Valentin-Auger-Laboratoire/athletix-data/architecture/INTEGRATION.md

# Intégration réseau : du muscle à la base de données

> Auteur : Othmen Al Bydeoi — architecture système. Version 1.0 (novembre 2026).

## 1. Le chemin des données

```
 Muscle ──► MyoWare 2.0 ──► ESP32-S3 ══ Bluetooth LE ══► Application ══ HTTPS ══► API PHP ──► MySQL
          (enveloppe        (RMS, % MVC,  (GATT, 50 Hz)   (affichage,    (POST +    (backend/)  (résultats,
           analogique)       alerte)                       résumé)        jeton)                  calibrations)
```

Il y a **deux liaisons**, chacune avec son rôle :

| Liaison | Technologie | Ce qui passe | Fréquence |
|---|---|---|---|
| Brassard → application | Bluetooth Low Energy, GATT (voir `GATT.md`) | chaque mesure, 8 octets | ~50 par seconde |
| Application → serveur | HTTPS, formulaire POST + jeton de session | un **résumé** par séance, une ligne par calibration | quelques fois par jour |

**Le brassard ne parle jamais directement au serveur.** Il n'a pas d'accès Internet, ni de compte. C'est l'application, déjà connectée avec le jeton de l'utilisateur, qui relaie. Cela corrige une incohérence de la version précédente : `update_hardware.php` demandait au brassard le jeton de session d'un utilisateur, ce qu'un objet connecté ne peut pas avoir.

## 2. Routes de l'API ajoutées

Toutes en `POST`, avec le champ `token` (jeton de session), comme le reste de l'API.

### `save_seance.php`

Enregistre une séance terminée et son résumé EMG, dans une transaction (soit tout est enregistré, soit rien).

| Champ | Obligatoire | Contrôle |
|---|---|---|
| `discipline` | oui | 1 à 50 caractères |
| `duree_s` | oui | 1 à 21 600 (6 h) |
| `nb_echantillons` | oui | ≥ 0 |
| `intensite_moyenne_pct`, `intensite_max_pct` | oui | 0 à 255, moyenne ≤ max |
| `temps_effort_intense_s` | oui | 0 à `duree_s` |
| `nb_alertes` | oui | ≥ 0 |
| `simule` | non | `1` si les données viennent du brassard simulé |
| `numero_serie`, `firmware` | non | si présents : le brassard est créé ou mis à jour et lié à l'utilisateur |
| `ref_mvc_mv` | non | 100 à 3300 |
| `temps_zone_repos_s`, `temps_zone_moderee_s`, `temps_zone_soutenue_s` | non | 0 à 21 600 (zones < 20 %, 20–50 %, 50–75 % ; la zone ≥ 75 % est `temps_effort_intense_s`) |
| `nb_contractions` | non | 0 à 65 535 (hystérésis 30 / 20 %) |
| `indice_fatigue_pct` | non | −100 à 1000 (expérimental, voir `lib/services/analyse/analyse_seance.dart`) |
| `courbe` | non | liste JSON d'au plus 2 000 entiers de 0 à 255, une valeur toutes les 5 s |
| `distance_m`, `denivele_m`, `vitesse_moy_kmh`, `nb_pas` | non | GPS et accéléromètre du téléphone ; la vitesse accepte la virgule |
| `fc_moy`, `fc_max` | non | 30 à 230 / 240, moyenne ≤ max (ceinture cardio) |
| `temperature_c`, `humidite_pct`, `meteo_code` | non | météo Open-Meteo au départ (code WMO 0 à 99) |
| `ressenti_fatigue`, `douleur` | non | 0 à 10 |
| `sommeil`, `commentaire` | non | 20 et 500 caractères au plus |
| `mode_adapte` | non | `1` si la séance a été faite en mode adapté |

Les champs facultatifs demandent la migration `003_contexte_telephone.sql`.

Réponse : `{"status":"success","session_id":12}` ou `{"status":"error","message":"…"}` avec un message précis.

### `save_calibration.php`

| Champ | Contrôle |
|---|---|
| `numero_serie` | 4 à 32 caractères (lettres, chiffres, tirets) |
| `firmware` | facultatif |
| `ref_mvc_mv` | 100 à 3300 |

## 3. Le choix à trancher : Bluetooth dans le navigateur ou application Android ?

L'application est aujourd'hui en **Flutter Web**. Le Bluetooth dans un navigateur passe par l'API **Web Bluetooth**, qui a des limites fortes :

| | Web Bluetooth (Chrome) | Application Android (Flutter) |
|---|---|---|
| Navigateurs / appareils | Chrome et Edge sur ordinateur et Android. **Pas** sur iPhone, **pas** sur Firefox | tous les Android récents |
| Conditions | site en HTTPS, l'utilisateur doit cliquer pour choisir l'appareil | permissions Bluetooth à demander |
| Identifiant de l'appareil | opaque (pas d'adresse MAC) → on utilise le numéro de série GATT | adresse MAC disponible |
| Démo en ligne (GitHub Pages) | ✅ fonctionne tel quel | ❌ il faut installer l'APK |
| Effort | moyen : appels JavaScript depuis Dart | moyen : un package BLE (par ex. `flutter_blue_plus`) |

**Recommandation :** garder la version web pour la démo, et viser une **version Android** pour l'usage réel avec le brassard. Le code est déjà préparé pour les deux : l'écran de séance ne dépend que de l'interface `SourceBrassard` (`lib/services/brassard/source_brassard.dart`). Il suffit d'écrire une classe `BrassardBle` qui implémente cette interface avec le package choisi, sans toucher aux écrans. Vérifier au moment du choix le support web et Android du package dans sa documentation.

## 4. Ce qui marche déjà sans le vrai brassard

1. **Dans l'application :** `BrassardSimule` produit des paquets **au format GATT exact** (mêmes octets), les décode avec le vrai décodeur, et l'écran de séance affiche le % MVC. À la fin, le résumé est envoyé à `save_seance.php`. Tout le chemin est testé, sauf la radio.
2. **Avec la carte reçue (Thing Plus ESP32-S3) :** `hardware/faux-brassard-ble/` publie le service GATT complet avec un signal simulé (ou le vrai signal du MyoWare si on change une ligne). On peut le tester avec l'application gratuite **nRF Connect** : on doit voir le service `abad0000-…`, s'abonner à la mesure et voir arriver les paquets.

## 5. Étapes suivantes

> Mise à jour le 12 novembre 2026 : décision prise et travail fait en attendant le matériel.

| Étape | Qui | État |
|---|---|---|
| Choisir web ou Android (§3) | équipe | ✅ **décidé** : web pour la démo en ligne, **Android** (projet `android/`, compilé avec Android Studio) pour l'usage réel avec le brassard |
| Écrire `BrassardBle` (connexion réelle) | équipe | ✅ écrit : `lib/services/brassard/brassard_ble.dart` (package `flutter_blue_plus`), ⏳ à tester avec le vrai brassard |
| Écran de choix du brassard et de calibration (O3, O4) | équipe | ✅ `lib/screens/brassard_screen.dart`, `calibration_screen.dart` |
| Historique des séances | équipe | ✅ route `get_seances.php` et écran « Mes séances » |
| Nouvelle règle de score du classement | équipe | ✅ proposée et codée dans `get_classement.php` (voir `MCD_MLD.md` §5), à valider |
| Firmware final avec le vrai MyoWare et la vraie batterie | équipe | ✅ écrit : `hardware/firmware-brassard/`, calculs testés sur ordinateur, ⏳ à flasher |
| Brassard réel câblé, mesuré, calibré | équipe | ⏳ matériel (voir `hardware/PROTOCOLE-DE-TEST.md`) |

### Ajouts à l'API

- `get_seances.php` (POST + jeton) : les dernières séances de l'utilisateur (paramètre `limite`, 1 à 500, 100 par défaut) avec leur résumé EMG et, depuis la migration `003`, les mesures du téléphone, le ressenti et la courbe. Avec `id` : une seule séance, avec son tracé GPS (migration `004`).
- `save_seance.php` accepte aussi (migration `004`) `trace` (JSON `[[lat, lon, s, %], …]`, 2 à 500 points, temps croissant), `nb_series`, `client_uuid` (UUID v4 : une séance renvoyée après une coupure n'est pas enregistrée deux fois, la réponse porte `deja_enregistree`) et `fin_il_y_a_s` (séance envoyée plus tard, 0 à 30 jours ; durée mesurée par le téléphone ou le brassard, donc juste même si l'horloge du téléphone est fausse).
- `export_donnees.php` (POST + jeton) : RGPD, toutes les données du compte en JSON (sans mot de passe, jetons ni code de vérification).
- `supprimer_compte.php` (POST + jeton + `password`) : RGPD, supprime le compte et toutes ses données ; les brassards restent mais ne sont plus liés à personne.
- `save_seance.php` et `save_calibration.php` acceptent un champ facultatif `batterie` (0 à 100 %), enregistré dans `brassards.batterie_niveau`.
- `get_hardware.php` lit maintenant le dernier brassard de l'utilisateur dans `brassards` (batterie, dernière synchronisation, numéro de série). `update_hardware.php` et `save_performance.php` sont supprimés (migration `002`).
- Toute l'API est testée sur une vraie base MariaDB : `tests/api/test_api.sh` (93 vérifications), relancé par GitHub à chaque envoi.
- `save_seance.php` accepte aussi (migration `005`) la fatigue mesurée par la fréquence médiane : `mdf_debut_hz`, `mdf_fin_hz`, `baisse_mdf_pct`, `courbe_mdf` (JSON, 200 valeurs au plus) ; `get_seances.php` et `export_donnees.php` les renvoient.

### Sécurité : relecture du 12 novembre 2026

Vérifié (et testé dans `tests/api/test_api.sh`) : toutes les requêtes SQL sont préparées ; chaque route protégée vérifie le jeton (seul son hash SHA-256 est en base, avec une date d'expiration) ; chaque lecture est filtrée par l'utilisateur du jeton (un autre compte ne voit ni l'historique, ni le détail par `id`, ni l'export) ; renvoyer l'identifiant `client_uuid` d'un autre compte crée une séance à soi, sans toucher à celle de l'autre ; cinq envois simultanés de la même séance n'en enregistrent qu'une (index unique, et l'erreur de doublon est rattrapée) ; la suppression du compte redemande le mot de passe et ne touche que ce compte ; l'export CSV neutralise les textes qui commencent par `=`, `+`, `-` ou `@` (sinon Excel les exécuterait comme des formules).

Limites connues du prototype, à traiter avant un vrai déploiement :
- ~~Pas de limite du nombre d'essais~~ : **corrigé le 13 novembre 2026** (migration `006`, `backend/limites.php`) : 5 mots de passe faux pour un même e-mail en 15 min (30 pour une même adresse IP), 3 renvois du code de vérification, 5 essais pour supprimer le compte, puis HTTP 429 « Trop d'essais : réessaie dans N min ». Les clés sont des empreintes SHA-256 (ni e-mail ni IP en clair), effacées au bout d'un jour. Testé dans `tests/api/test_api.sh`.
- **HTTP autorisé** pour joindre XAMPP sur le réseau local : le jeton circule en clair. En production : HTTPS obligatoire, et retirer `usesCleartextTraffic` du manifeste Android.
- **Données déclarées par le téléphone** : le serveur ne peut pas prouver qu'une séance vient vraiment du brassard (`simule=0`). Pour un classement sans triche, il faudrait que le brassard signe ses résumés.
- **Bluetooth** : l'appairage sécurisé avec code est écrit dans le firmware (`APPAIRAGE_SECURISE`, voir `hardware/firmware-brassard/SECURITE.md`) mais désactivé par défaut et pas encore essayé avec un téléphone (étape 9 du protocole de test).
