Valentin-Auger-Laboratoire/athletix-data/hardware/boitier/images/bac-batterie.jpg

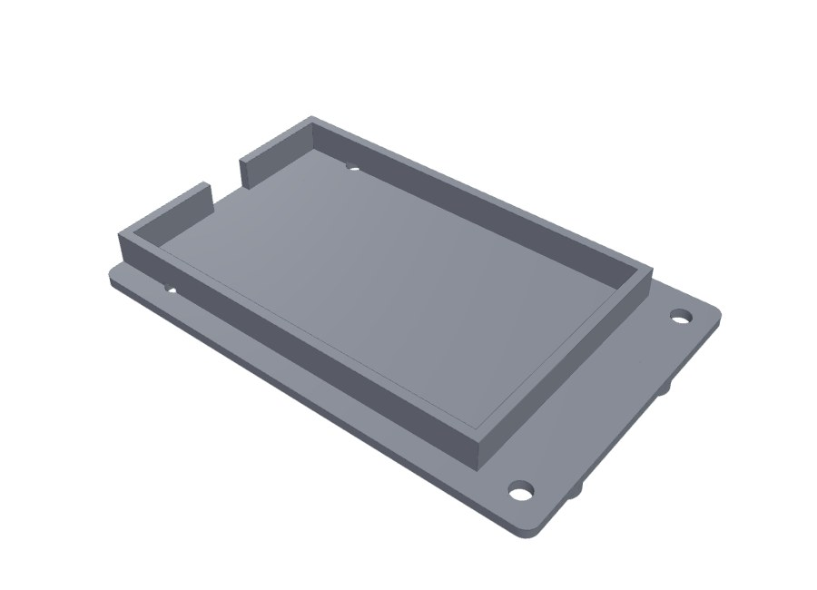
hardware/boitier/images/bac-batterie.jpg
