Valentin-Auger-Laboratoire/athletix-data/hardware/boitier/images/bouchon-usb.jpg

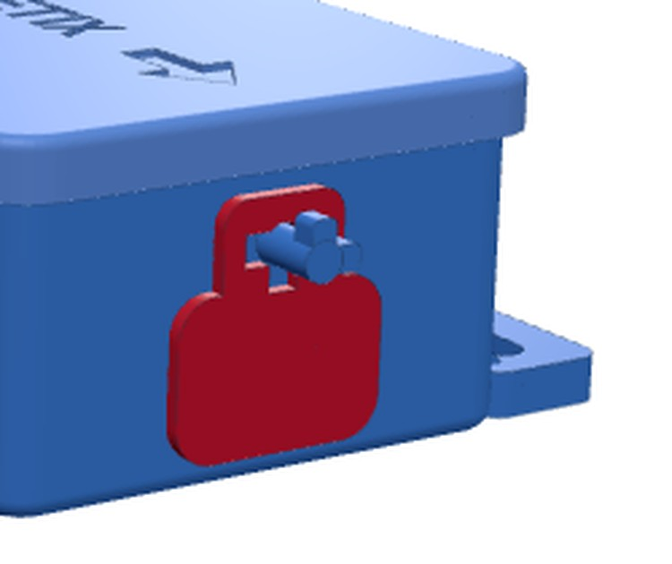
hardware/boitier/images/bouchon-usb.jpg
