Valentin-Auger-Laboratoire/athletix-data/hardware/boitier/images/boucle-3-barres.jpg

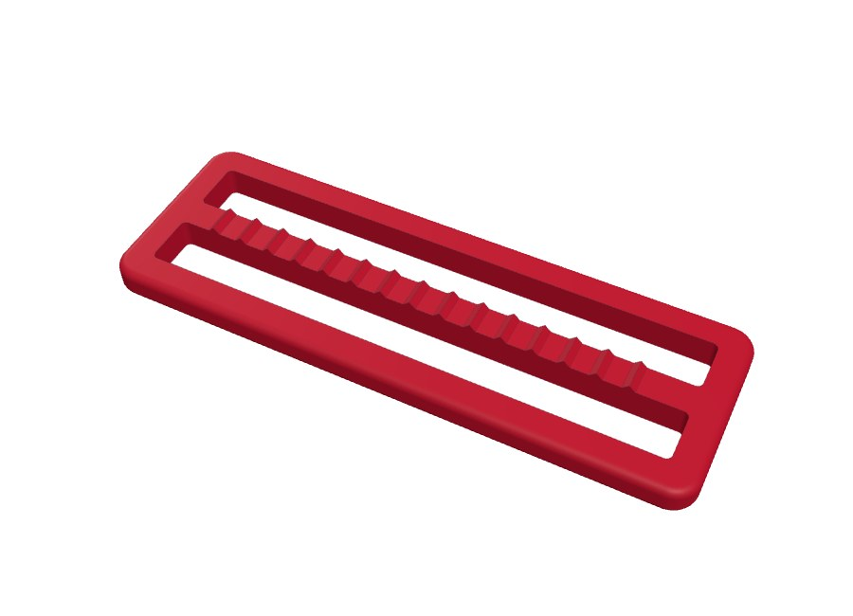
hardware/boitier/images/boucle-3-barres.jpg
