Valentin-Auger-Laboratoire/athletix-data/hardware/boitier/images/bout-interrupteur.jpg

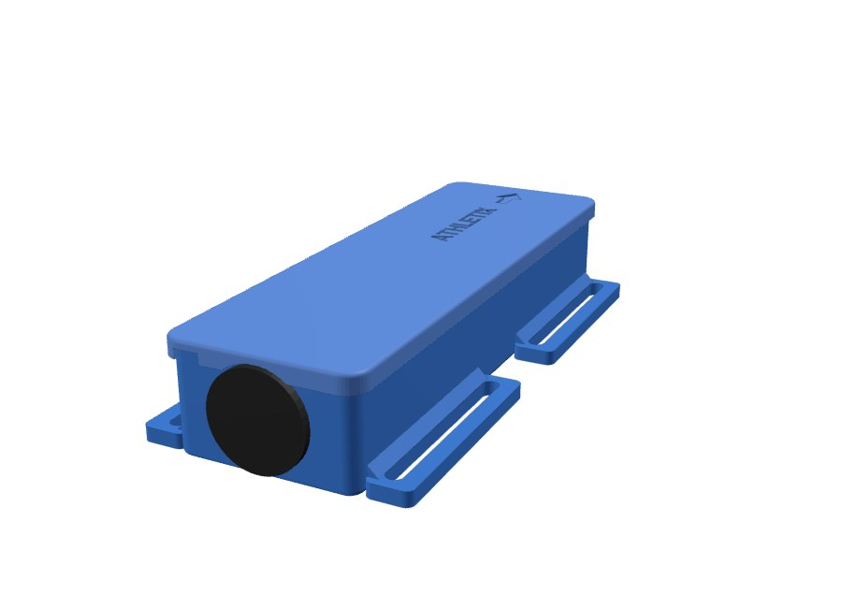
hardware/boitier/images/bout-interrupteur.jpg
