Valentin-Auger-Laboratoire/athletix-data/hardware/boitier/images/couvercle-dessous.jpg

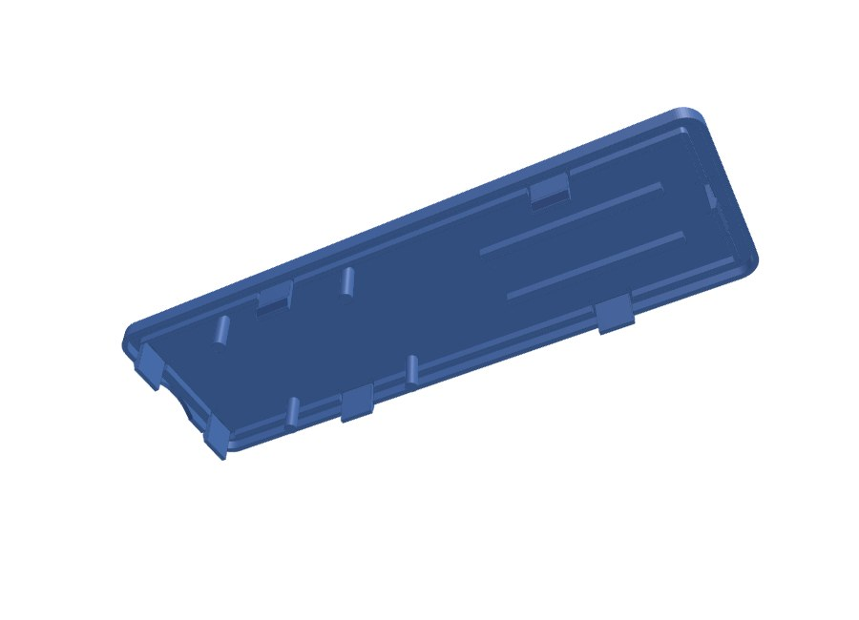
hardware/boitier/images/couvercle-dessous.jpg
