Valentin-Auger-Laboratoire/athletix-data/hardware/boitier/images/dessus-fleche.jpg

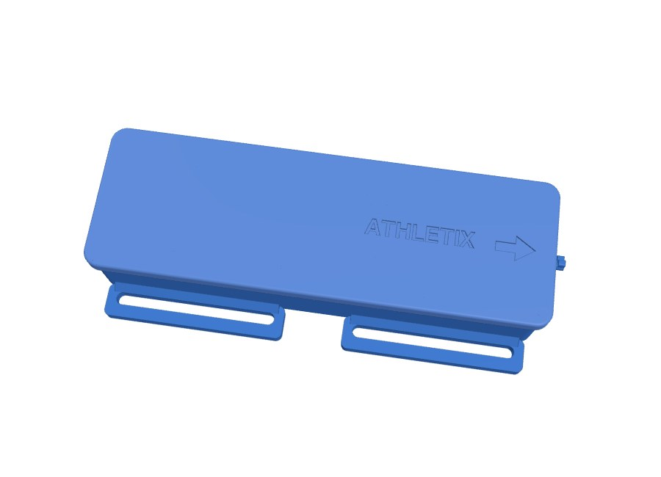
hardware/boitier/images/dessus-fleche.jpg
