Valentin-Auger-Laboratoire/athletix-data/hardware/boitier/images/fusion/06-couvercle-profil.jpg

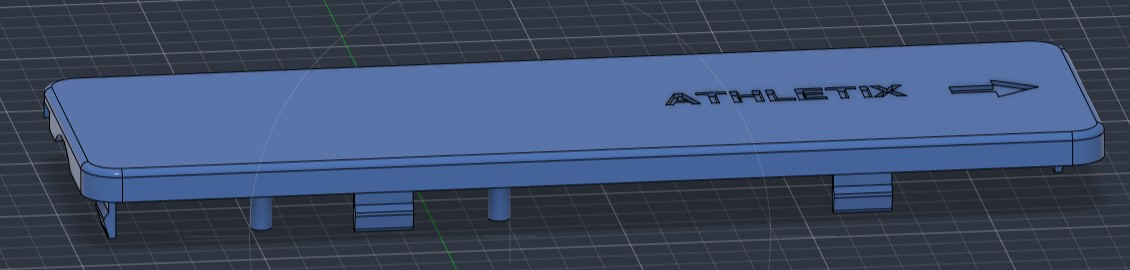
hardware/boitier/images/fusion/06-couvercle-profil.jpg
