Valentin-Auger-Laboratoire/athletix-data/hardware/boitier/images/fusion/07-boitier-vide-ds12lr.jpg

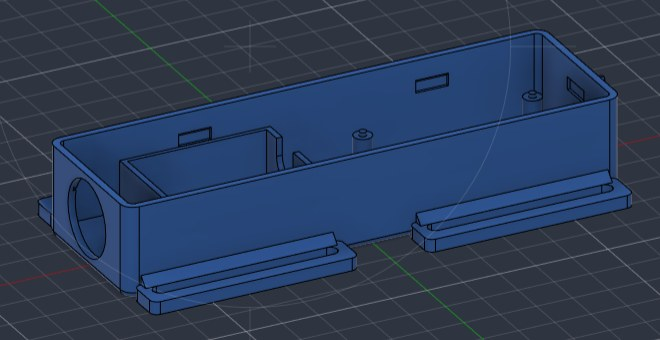
hardware/boitier/images/fusion/07-boitier-vide-ds12lr.jpg
