Valentin-Auger-Laboratoire/athletix-data/hardware/boitier/images/fusion/12-ensemble-petit-interrupteur.jpg

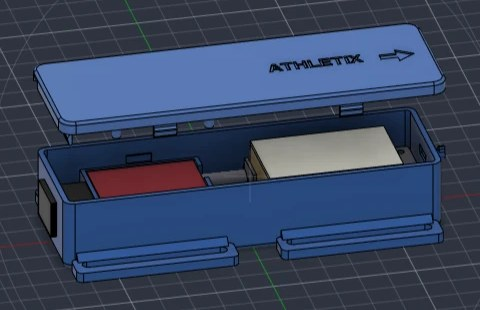
hardware/boitier/images/fusion/12-ensemble-petit-interrupteur.jpg
