Valentin-Auger-Laboratoire/athletix-data/hardware/boitier/images/interieur.jpg

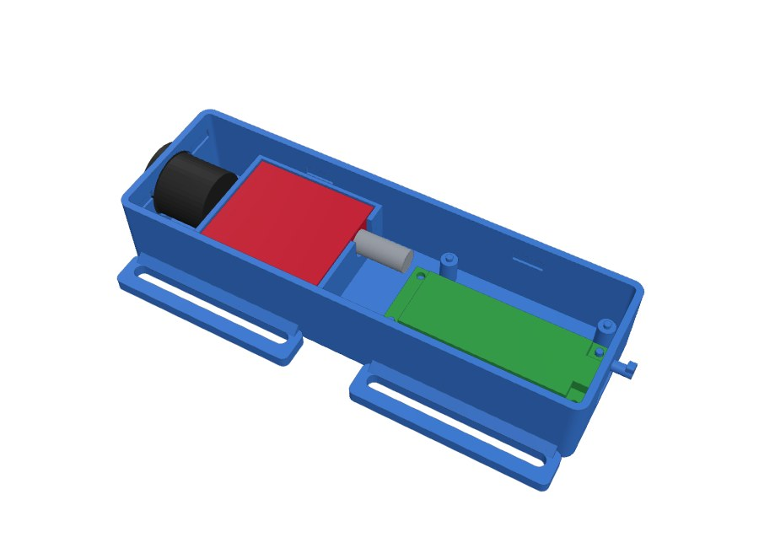
hardware/boitier/images/interieur.jpg
