Valentin-Auger-Laboratoire/athletix-data/mode-emploi/images/montre.jpg

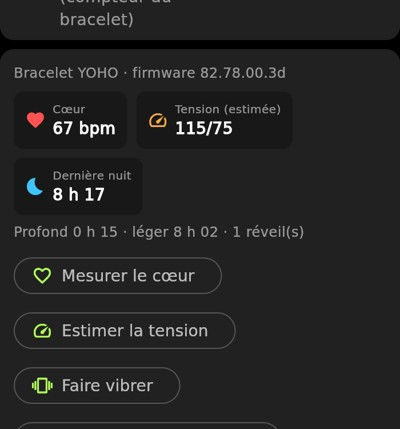
mode-emploi/images/montre.jpg
