Valentin-Auger-Laboratoire/athletix-data/mode-emploi/images/pose-electrodes.png

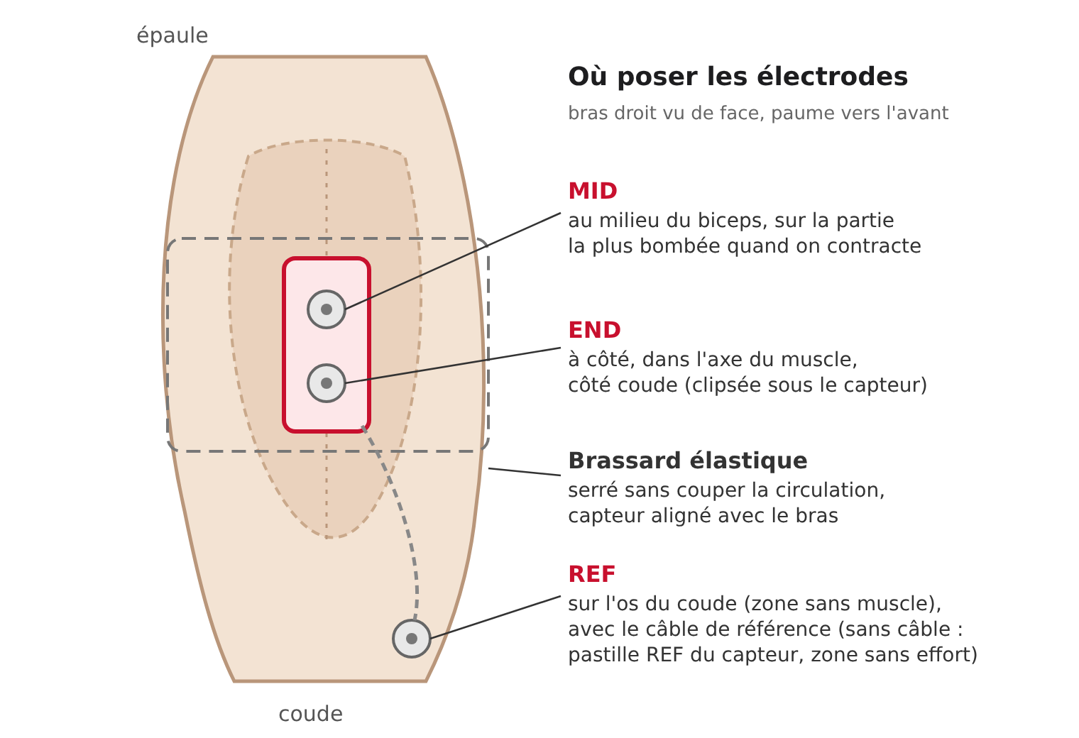
mode-emploi/images/pose-electrodes.png
