Valentin-Auger-Laboratoire/athletix-data/screenshots/montre-yoho-panneau.jpg

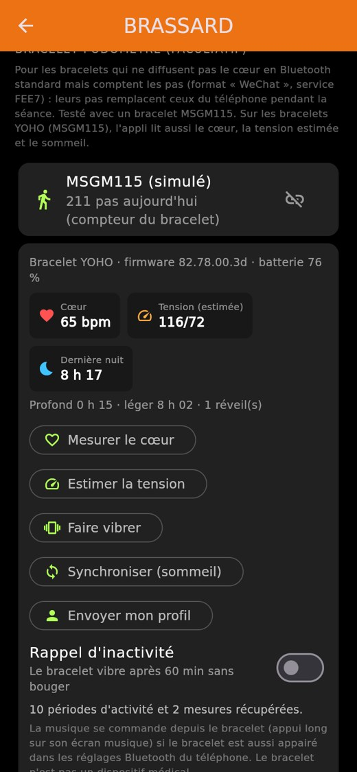
screenshots/montre-yoho-panneau.jpg
