Valentin-Auger-Laboratoire/athletix-data/hardware/boitier/fichiers/ds12lr/assemblage-complet.step

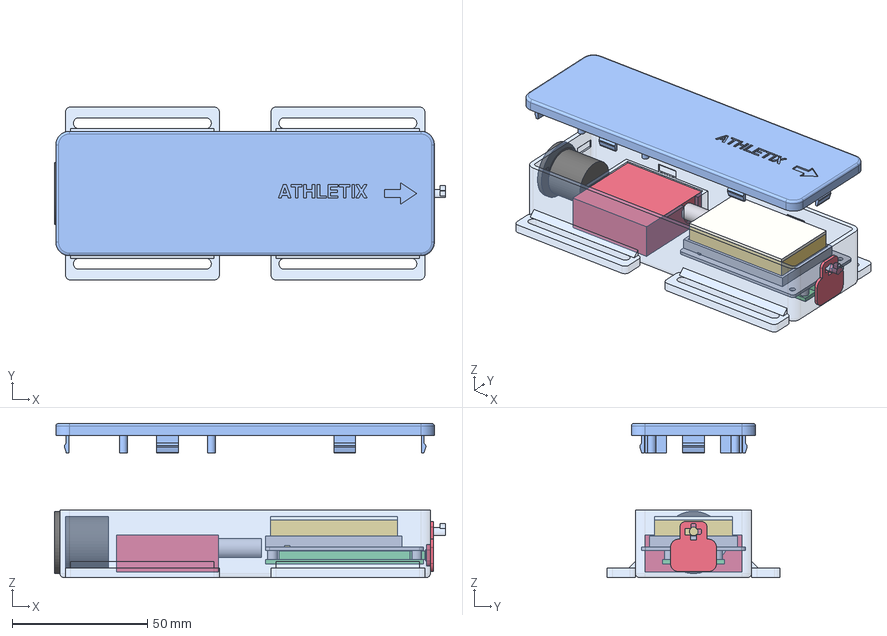
[picture p60: CAD file, 2026-11-14]
hardware/boitier/fichiers/ds12lr/assemblage-complet.step
144.6 x 64.0 x 57.0 mm
boitier
couvercle
bac batterie
bouchon USB
carte (volume)
batterie (volume)
mousse (volume)
myoware+link (volume)
interrupteur (volume)
fiche jack (volume)
