Valentin-Auger-Laboratoire/athletix-data/hardware/boitier/fichiers/petit-interrupteur/assemblage-complet.step

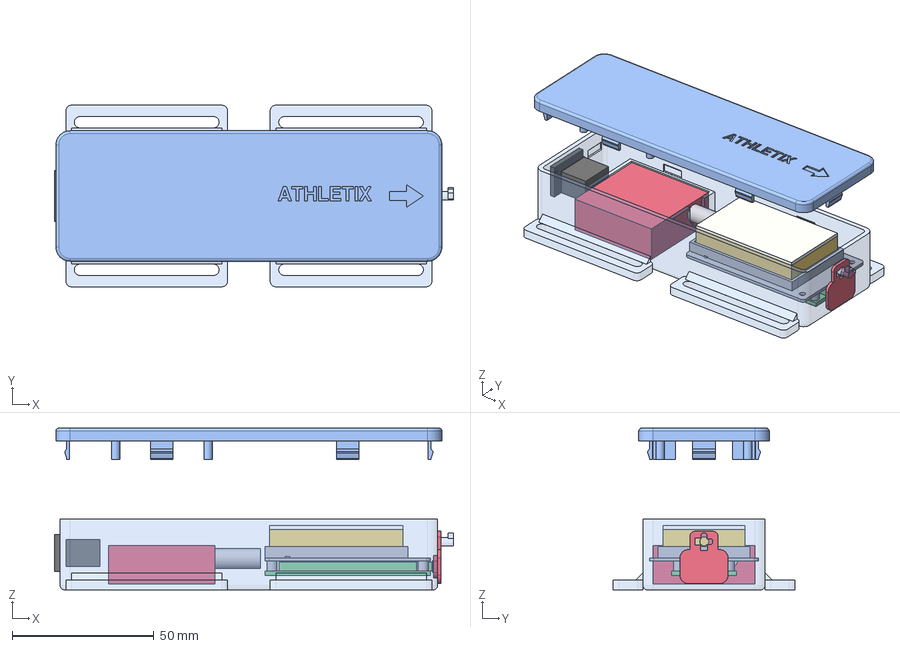
[picture p61: CAD file, 2026-11-14]
hardware/boitier/fichiers/petit-interrupteur/assemblage-complet.step
140.6 x 64.0 x 57.0 mm
boitier
couvercle
bac batterie
bouchon USB
carte (volume)
batterie (volume)
mousse (volume)
myoware+link (volume)
interrupteur (volume)
fiche jack (volume)
