Valentin-Auger-Laboratoire/athletix-data/hardware/boitier/fichiers/ds12lr/boitier.step

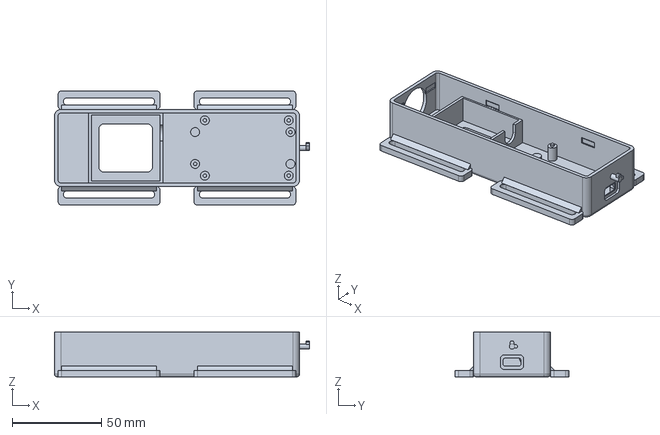
[picture p62: CAD file, 2026-11-14]
hardware/boitier/fichiers/ds12lr/boitier.step
142.6 x 64.0 x 25.0 mm
