Valentin-Auger-Laboratoire/athletix-data/hardware/boitier/fichiers/petit-interrupteur/bouchon-usb.step

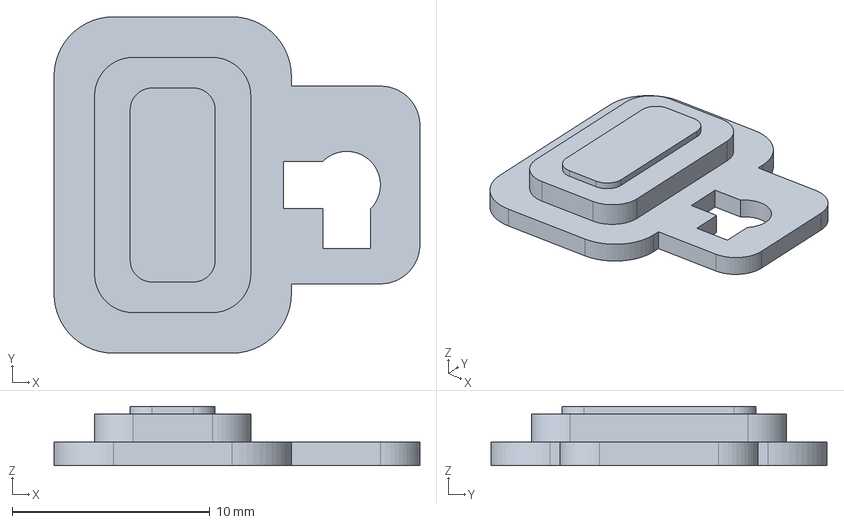
[picture p63: CAD file, 2026-11-14]
hardware/boitier/fichiers/petit-interrupteur/bouchon-usb.step
18.5 x 17.0 x 3.00 mm
