Valentin-Auger-Laboratoire/athletix-data/hardware/boitier/fichiers/ds12lr/serre-bande.step

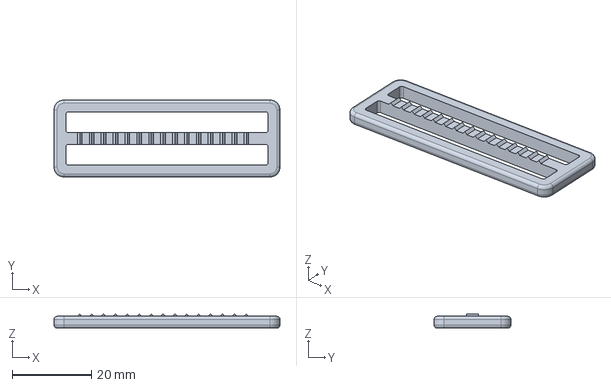
[picture p64: CAD file, 2026-11-14]
hardware/boitier/fichiers/ds12lr/serre-bande.step
57.0 x 19.4 x 3.60 mm
