Valentin-Auger-Laboratoire/athletix-data/hardware/boitier/fichiers/petit-interrupteur/couvercle.step

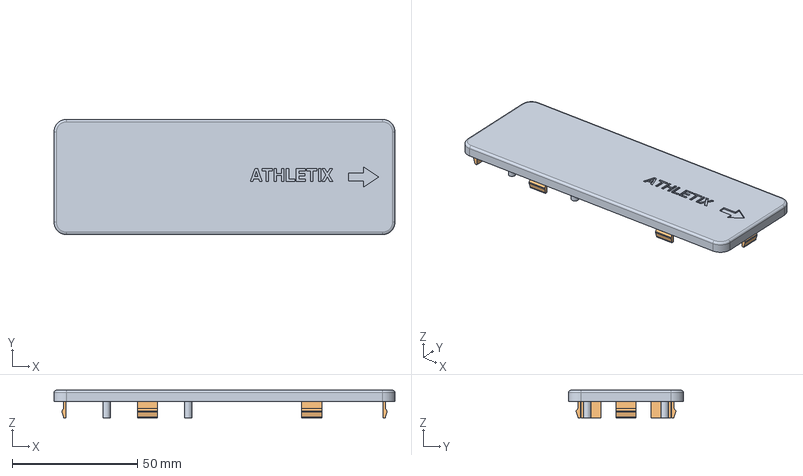
[picture p65: CAD file, 2026-11-14]
hardware/boitier/fichiers/petit-interrupteur/couvercle.step
136.0 x 46.0 x 11.0 mm
