Valentin-Auger-Laboratoire/athletix-data/hardware/boitier/fichiers/petit-interrupteur/bac-batterie.step

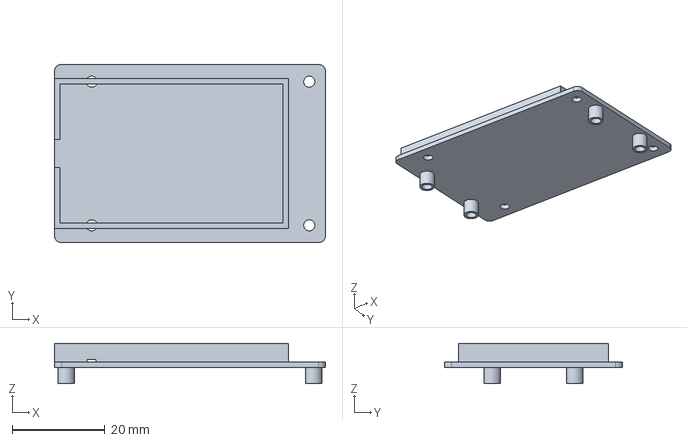
[picture p66: CAD file, 2026-11-14]
hardware/boitier/fichiers/petit-interrupteur/bac-batterie.step
58.4 x 38.4 x 8.70 mm
