Valentin-Auger-Laboratoire/athletix-data/(list of files, cad)

Other CAD files:
hardware/boitier/fichiers/ds12lr/couvercle.step
hardware/boitier/fichiers/petit-interrupteur/boitier.step
hardware/boitier/fichiers/ds12lr/bac-batterie.step
hardware/boitier/fichiers/petit-interrupteur/serre-bande.step
hardware/boitier/fichiers/ds12lr/bouchon-usb.step
hardware/boitier/fichiers/ds12lr/bac-batterie.stl
hardware/boitier/fichiers/ds12lr/boitier.stl
hardware/boitier/fichiers/ds12lr/bouchon-usb.stl
hardware/boitier/fichiers/ds12lr/couvercle.stl
hardware/boitier/fichiers/ds12lr/serre-bande.stl
hardware/boitier/fichiers/petit-interrupteur/bac-batterie.stl
hardware/boitier/fichiers/petit-interrupteur/boitier.stl
hardware/boitier/fichiers/petit-interrupteur/bouchon-usb.stl
hardware/boitier/fichiers/petit-interrupteur/couvercle.stl
hardware/boitier/fichiers/petit-interrupteur/serre-bande.stl
