Valentin-Auger-Laboratoire/athletix-data/hardware/schema_montage.png

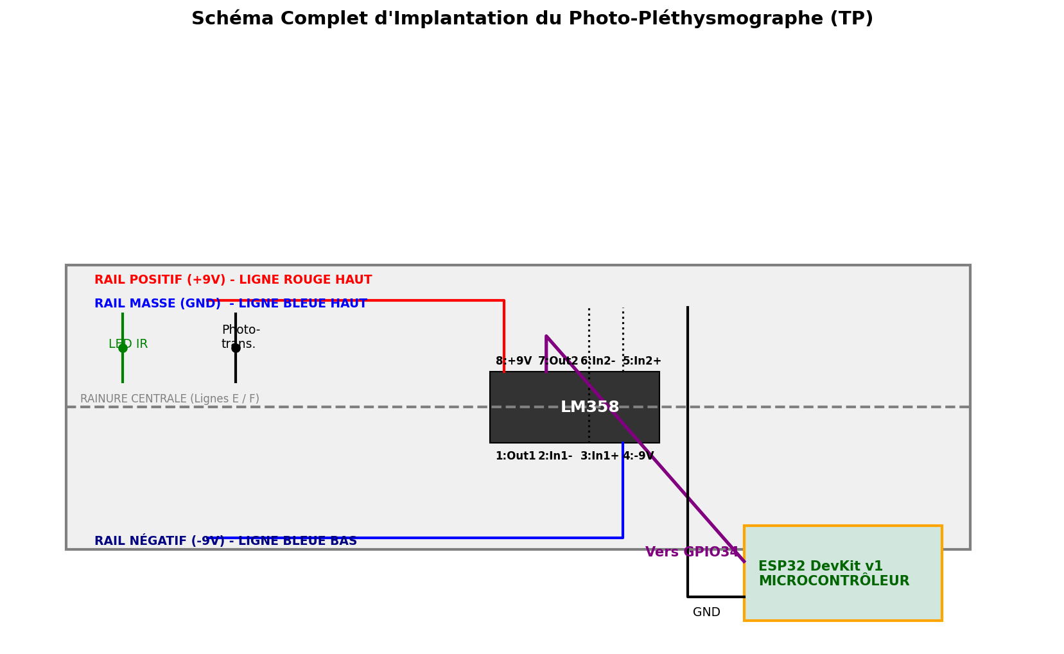
hardware/schema_montage.png
