Valentin-Auger-Laboratoire/athletix-data/hardware/simulation-emg/resultat-simulation.png

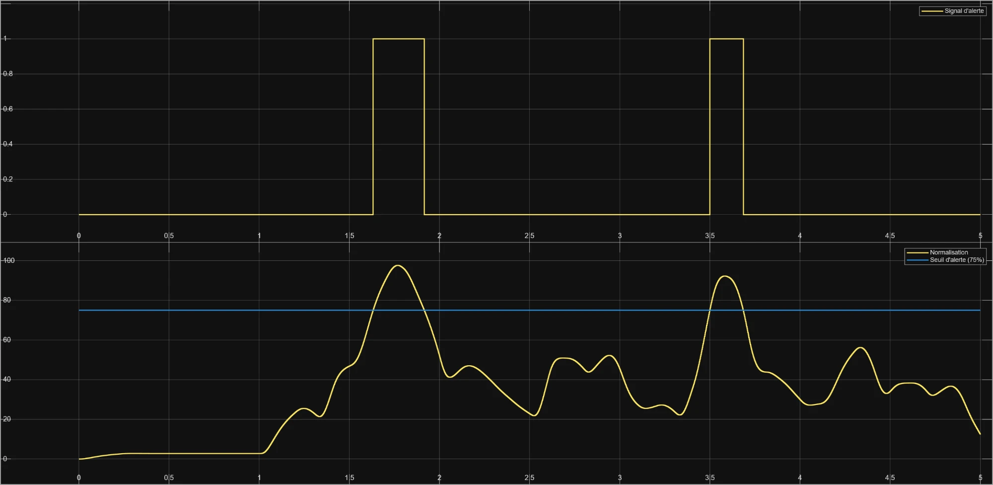
hardware/simulation-emg/resultat-simulation.png
