Valentin-Auger-Laboratoire/athletix-data/mode-emploi/images/calibration.jpg

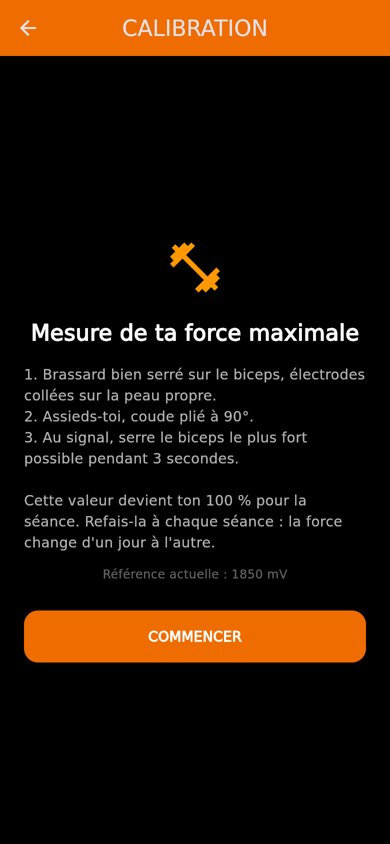
mode-emploi/images/calibration.jpg
