Valentin-Auger-Laboratoire/athletix-data/(commit log)

2026-11-02 Publication publique d'Athletix-Data
    - Application Flutter Web, API PHP/MySQL et partie électronique ESP32
    - Secrets retirés : configuration unique (config.local.php ignoré + config.example.php),
    URL de l'API centralisée dans lib/config.dart
    - Sécurité : password_hash, requêtes préparées partout, jeton de session,
    code de vérification random_int expirant après 10 minutes, CORS configurable
    - Bugs corrigés : classement, bind_param du profil, fréquence et antécédents cardio,
    état du brassard, déconnexion
    - Mentions d'honnêteté (BPM simulés, conseils générés par règles) et mode démo sans backend
    - database.sql, README FR/EN, icônes, build web dans docs/ pour GitH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
    [schema_montage.py, sketch.ino]
2026-11-06 Image d'aperçu pour les liens partagés (LinkedIn)
2026-11-09 Version finale : brassard EMG (MyoWare 2.0, ESP32-S3), équipe et simulation Simulink
2026-11-09 Équipe : 3 membres (comme sur la couverture du compte rendu)
2026-11-12 Simulation EMG : schéma du modèle et figure en meilleure résolution ; README : rencontre avec une patiente atteinte de sclérose en plaques et pistes pour le brassard
2026-11-12 README : schéma du modèle et résultat de la simulation affichés sur la page d'accueil
2026-11-12 README : images de la simulation affichées une seule fois (partie française)
2026-11-12 Appli : conseils cohérents (rythme selon niveau et fréquence, taille et poids utilisés, niveau Intermédiaire), questionnaire pré-rempli, menu du compte clarifié, mesures EMG à la place des moteurs GP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
2026-11-12 README : schéma du câblage présumé du brassard (d'après les composants commandés, non testé)
2026-11-12 Électronique : câblage présumé du brassard EMG en tête de hardware/ (légende, USB-C), premier capteur cardiaque gardé comme historique
2026-11-12 Architecture BLE (GATT), MCD/MLD, MCT et intégration de la séance EMG
2026-11-12 Démo recompilée avec l'écran de séance EMG (brassard simulé)
2026-11-12 README : réalisations d'Othmen dans le dépôt (architecture, brassard simulé, séances, firmware de test)
2026-11-12 README : réalisations de Valentin dans le dépôt (application, API, câblage, documentation)
2026-11-12 README : Valentin chef de projet, Maxence sur la simulation
2026-11-12 README : détail complet des réalisations de Valentin
2026-11-12 README : diagramme de Gantt attribué à Maxence
2026-11-12 Feuille de route : ce qu'il reste à faire avant et après la réception du matériel, résumé dans le README
2026-11-12 Feuille de route : boîtier déjà modélisé sous Fusion 360, fichiers à ajouter
2026-11-12 Feuille de route : points d'avancement à la place du rapport final
2026-11-12 Feuille de route : jalon 1 du MESPI de 2e année (rapport d'avancement) et objectif prototype en S3
2026-11-12 Sans le matériel : API testée sur une vraie base (41 vérifications), historique des séances, score du classement à partir des mesures EMG, nettoyage des tables (migration 002), connexion Bluetooth ré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
2026-11-12 Firmware final (vrai MyoWare, jauge de batterie, calculs testés), câblage vérifié sur les fiches SparkFun, protocole de test, pièces à compléter, docs d'architecture et feuille de route à jour, démo 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
2026-11-12 README : lien direct vers la feuille de route ; feuille de route : compléter l'application (GPS, accéléromètre, météo, cardio, graphiques, fatigue, contexte) et état des pistes sclérose en plaques
2026-11-12 Pièces manquantes : solutions sans commande (câble audio recyclé soudé, électrodes ECG standard), schéma et protocole de test à jour
2026-11-12 Le téléphone en plus du brassard : graphiques (direct, détail, évolution), GPS, pas, météo, ceinture cardio, ressenti après la séance, semaines moins bonnes expliquées, indice de fatigue expérimental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
2026-11-12 Natation (résumé gardé dans le brassard, firmware 1.1), tracé du parcours et vitesse/intensité, séries en musculation, séances envoyées plus tard sans doublon, objectif de la semaine, carnet PDF, RGP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
2026-11-12 Feuille de route refaite (fait / reste à faire), README à jour (nouvelles fonctions, captures, badge des tests), API, firmware 1.1 et protocole de test (étape natation) documentés, avertissement : pr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
2026-11-12 Règle de score validée ; schéma de câblage complété (capteur posé sur le muscle, électrodes ECG standard, câble audio recyclé, polarité de la batterie, pas étanche) ; APK Android compilé et publié pa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
2026-11-12 Gantt mis à jour (Excel modifiable + images), relecture de sécurité (envois simultanés, isolation entre comptes, injection CSV), 77 vérifications de l'API, lien vers l'APK
    [gantt.xlsx]
2026-11-12 Schéma : câble jack dessiné (prise du Link Shield, fiche mâle, câble, 3 soudures, zoom sur la fiche) ; Gantt affiché dans le README ; hébergement de l'API sur un PC avec XAMPP et ngrok
2026-11-12 Feuille de route : lien direct vers l'APK
2026-11-12 Comparaison automatique mesure / simulation (journal USB du firmware, scripts, exemple, 12 tests), analyse des risques, vidéo de démonstration ; correction : après l'enregistrement, ouvrir la séance 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
    [capturer.py, comparer_simulation.py, firmware-brassard.ino, generer_exemple.py, modele.py]
2026-11-13 README : comparaison avec la simulation affichée sur la page principale, réalisée par Valentin Auger
2026-11-13 Mode d'emploi du brassard (PDF de 2 pages, même mise en page que le carnet), illustration de la pose des électrodes, aperçu dans le README
2026-11-13 Mode d'emploi ouvert depuis l'appli, cahier des charges du boîtier (implantation à l'échelle, dimensions des pièces, version étanche), fiche de test à imprimer générée depuis le protocole
2026-11-13 README : section « Documents pour les essais » en haut de la page (mode d'emploi, fiche de test, boîtier)
2026-11-13 Feuille de route à jour (13 nov.) : documents des essais, boîtier, APK, version anglaise non retenue
2026-11-13 Fatigue par la fréquence médiane (firmware 1.2, signal brut), firmware exécuté sur ordinateur, fond de carte OpenStreetMap
2026-11-13 Analyse de la fatigue mesurée (mesures/), fatigue par semaine dans l'évolution, README et feuille de route à jour, démo recompilée
2026-11-13 Feuille de route : second brassard non retenu (matériel insuffisant)
2026-11-13 Prêt pour le vrai brassard : reconnexion automatique, avertissements en séance, rappel de calibration, montre cardio
2026-11-13 Bracelet podomètre (format WeChat FEE7/FEA1) : pas du bracelet MSGM115 pendant les séances
2026-11-13 Feuille de route : cœur et musique du bracelet MSGM115 à décoder plus tard
2026-11-13 Bracelet YOHO (MSGM115) : cœur, tension estimée, sommeil, vibration, profil, rappel d'inactivité
    Format du service CC00 retrouvé dans l'appli d'origine du bracelet (compatibilité, aucun code repris) :
    protocole_yoho.dart (commandes et messages), montre_yoho.dart (liaison et synchronisation),
    panneau dans l'écran Brassard, cœur du bracelet pendant une séance sans ceinture.
    15 tests, fiche architecture/BRACELET-YOHO.md, README et feuille de route à jour.
2026-11-13 README : section « Ma montre reliée à l'application » (captures, schéma), bracelet MSGM115 simulé dans la démo
    Le bracelet simulé renvoie les mêmes octets que le vrai (valeurs fictives) et passe par le même décodeur ;
    liaison YOHO indépendante du transport (Bluetooth ou simulé) ; test de bout en bout (16 tests).
2026-11-13 Batterie de la montre et de la ceinture cardio : accueil, cartes, séance, alerte à 15 %
    Service Bluetooth standard 0x180F (ceintures, montres) ou batterie YOHO (CC03) ; pastille commune ; 4 tests.
2026-11-13 Documents à jour : Gantt (firmware 1.2, montre), mode d'emploi (section montre), protocole et fiche de test (étape 10 montre), feuille de route, analyse des risques
    [gantt.xlsx]
2026-11-13 Nouvelle vidéo de démo (montre, fatigue), cœur « ceinture ou montre » dans le détail, mode d'emploi avec la capture à jour
2026-11-14 Boîtier du brassard : boîtier unique à clips (sans vis), deux versions d'interrupteur, STEP/STL, notice de montage et de pose ; mode d'emploi et fiche de test à jour
    [assemblage-complet.step, bac-batterie.step, bac-batterie.stl, boitier.step, boitier.stl, bouchon-usb.step, bouchon-usb.stl, couvercle.step]
2026-11-14 Boîtier : bouchon USB-C retenu par un pion à tête fendue (plus de ficelle), images et notice à jour
    [assemblage-complet.step, bac-batterie.step, boitier.step, boitier.stl, bouchon-usb.step, couvercle.step, serre-bande.step, serre-bande.stl]
2026-11-14 Boîtier : étude de résistance des matériaux (clips, passants, pion du bouchon) et corrections du modèle ; page interactive, notice et images à jour
    [assemblage-complet.step, bac-batterie.step, boitier.step, boitier.stl, bouchon-usb.step, bouchon-usb.stl, couvercle.step, couvercle.stl]
2026-11-14 Étude RDM du boîtier : image des 3 points faibles entourés sur le modèle, avant / après
2026-11-14 Boîtier : 12 vues sous Fusion 360 par Valentin Auger (version finale), dans les README
2026-11-14 README : 10 vues Fusion 360 sur la page principale ; Gantt, feuille de route et analyse des risques à jour (boîtier fait)
    [gantt.xlsx]
2026-11-14 README : section dédiée à l'étude RDM du boîtier (Valentin Auger), lien en haut de page
2026-11-14 README : tâches de Valentin Auger complétées dans le tableau de l'équipe (boîtier, étude RDM, firmware, montre, documents, sécurité, APK) en FR et EN
2026-11-14 Boîtier : cahier des charges mis à jour avec le boîtier réalisé (pièces, exigences et réponses, version étanche, avant d'imprimer)
2026-11-14 Retrait des pistes abandonnées (2e brassard, capteur de température, version anglaise) et du test du faux brassard sur un ESP32 classique, partout
2026-11-14 Feuille de route : étape « carte seule » remise comme avant
2026-11-14 Feuille de route : partie « plus tard » retirée (tout est fait et listé dans « Ce qui est fait »), rapport du jalon 1 retiré (feuille de route, README, Gantt), montre à jour
    [gantt.xlsx]
